litang578-coder/Antigravity-Code/README.md

# 基于STM32的锂电池太阳能智能充电系统设计

> 说明：本 README 根据毕业论文正文整理，已移除 Word 文档第一页封面、学号、姓名、学院、专业、指导教师等个人信息；为避免图片或截图携带敏感信息，本文仅保留文字、表格与参考文献，谢辞部分已省略。

## 摘要

随着新能源应用、嵌入式控制技术和物联网通信技术的发展，太阳能供电与锂电池储能相结合的充电系统在便携式电子设备、户外监测终端和低功耗物联网节点等场景中具有一定应用价值。太阳能板输出容易受到光照强度、环境温度和负载状态影响，输出电压、电流和功率具有波动性；同时，锂电池充电过程对电压、电流和温度控制要求较高，若缺少有效的状态监测和保护措施，容易影响电池寿命和系统运行安全。因此，设计一款具有太阳能输入调节、锂电池充电管理和远程监测功能的智能充电系统具有实际意义。

本文设计了一种基于STM32的锂电池太阳能智能充电系统。系统以STM32F103C8T6单片机作为主控核心，选取LM2596S DC-DC降压模块、TP4056锂电池充放电模块、INA226/INA3221电压电流采样模块、DS18B20温度检测模块、两路继电器模块、OLED显示模块和ESP8266无线通信模块完成样机搭建。硬件部分采用模块化方式实现太阳能输入、功率变换、锂电池充电、参数采集、执行保护、本地显示和无线通信等功能。软件部分围绕数据采集、充电状态判断、MPPT程序控制、继电器控制、MQTT通信、OneNET平台数据交互和移动端APP控制进行设计，实现了设备端采集、云平台传输和移动端显示控制之间的协同运行。

测试结果表明，系统能够完成太阳能充电管理、关键参数采集、本地状态显示、远程数据上传和异常保护等功能。在当前测试条件下，系统MPPT跟踪效率达到94%以上；充电阶段切换精度满足电压±0.02V、电流±50mA的设计要求；Wi-Fi通信延迟小于1s；硬件保护响应时间不超过10ms，软件保护响应时间不超过100ms；在典型阴天光照条件下，系统能够连续运行6h以上。该设计基本满足任务书提出的功能和性能指标，可为小型太阳能充电系统及低功耗物联网设备供电管理提供一定参考。

关键词：STM32；锂电池充电；MPPT；MQTT；太阳能供电

## Abstract

With the development of renewable energy, embedded control and IoT technology, solar charging systems for lithium batteries have been increasingly used in portable devices, outdoor monitoring terminals and low-power IoT nodes. However, the output of solar panels is affected by illumination, temperature and load, while lithium batteries require accurate control of voltage, current and temperature during charging. Therefore, this thesis designs an STM32-based intelligent solar charging system for lithium batteries.

The system uses STM32F103C8T6 as the main controller. Hardware modules such as the LM2596S DC-DC step-down module, TP4056 lithium battery charging module, INA226/INA3221 voltage and current sampling modules, DS18B20 temperature sensor, relay module, OLED display and ESP8266 Wi-Fi module are selected to build the system. The software realizes data acquisition, charging-state judgment, MPPT control, relay control, MQTT communication, OneNET data interaction and mobile APP control. The system can collect voltage, current, power, temperature and battery status, and upload the data to the cloud platform through MQTT.

Test results show that the system can complete solar charging management, parameter monitoring, local display, remote data uploading and safety protection. Under the current test conditions, the MPPT tracking efficiency is above 94%; the charging-stage switching accuracy meets the requirements of ±0.02V for voltage and ±50mA for current; the Wi-Fi communication delay is less than 1s; the protection response time meets the design requirements; and the system can operate continuously for more than 6h under typical cloudy conditions. The design basically meets the expected requirements and provides a reference for small solar charging systems and low-power IoT devices.

**Key words:** STM32; lithium battery charging; MPPT; MQTT; solar power supply

## 1 绪论

### 1.1 研究背景

随着新能源利用方式、嵌入式控制技术和物联网通信技术的发展，太阳能供电与锂电池储能相结合的充电系统逐渐应用于便携式电子设备、户外监测终端和低功耗物联网节点等场景。太阳能具有来源广泛、运行噪声低和环境友好等特点，但光伏板输出容易受到光照强度、环境温度和负载状态影响，其输出电压、电流和功率并不稳定。因此，在太阳能充电系统中，需要对输入功率变化进行检测和调节，以提高太阳能输入的利用效果[<sup>\[1\]</sup>](#_Ref3555)。

锂电池具有能量密度较高、自放电率较低和循环使用能力较好的特点，在智能终端、储能设备和嵌入式系统中应用广泛。与此同时，锂电池对充电电压、充电电流和工作温度较为敏感，若充电控制方式不合理，可能造成电池寿命下降，严重时还会影响系统运行安全。因此，锂电池充电过程通常需要结合涓流、恒流和恒压等阶段控制，并通过电压、电流和温度等参数监测为安全充电提供依据<sup>[\[2\]](#_Ref3832)[\[7\]](#_Ref3839)</sup>。

传统小型充电装置多侧重本地充电功能，对太阳能输入波动、电池状态变化和远程运行状态的综合管理不足。随着STM32微控制器、Wi-Fi通信模块和MQTT协议在物联网设备中的应用[<sup>\[3\]</sup>](#_Ref3907)，嵌入式系统可以同时完成数据采集、状态判断、执行控制和远程信息交互。基于此，本文围绕基于STM32的锂电池太阳能智能充电系统展开设计，将太阳能输入调节、锂电池充电管理和远程监测功能结合起来，具有一定的工程实践意义。

### 1.2 研究目的与意义

本文的研究目的是设计一套基于STM32的锂电池太阳能智能充电系统，使系统能够在太阳能输入不稳定的条件下完成锂电池充电管理、运行参数采集、安全保护和远程状态监测。系统以太阳能板作为输入源，以STM32作为主控单元，通过电压电流采样模块和温度检测模块获取系统运行状态，并结合继电器、显示模块和通信模块完成本地控制与远程交互。

本设计的意义主要体现在三个方面。首先，在能源利用方面，系统引入MPPT控制策略，使太阳能输入端能够根据采样结果调整工作点，为提高光伏输入利用率提供基础。其次，在电池管理方面，系统围绕锂电池充电特性进行阶段判断，并结合电压、电流、温度等信息实现保护控制，有助于提高充电过程的安全性。最后，在远程监测方面，系统通过ESP8266和MQTT协议上传运行信息，使用户能够在移动端查看电池状态、充电状态和异常提示，提升系统使用和调试的便利性。

### 1.3 本文主要研究内容

本文围绕“基于STM32的锂电池太阳能智能充电设计”展开研究，主要内容如下。

（1）分析锂电池太阳能充电系统的设计需求，明确系统需要完成的太阳能输入管理、锂电池充电控制、状态采集、安全保护、本地显示和远程通信等功能。

（2）研究光伏电池输出特性和常用MPPT控制方法，结合本系统的采样条件和控制需求，确定适用于样机设计的MPPT控制策略，为太阳能输入端工作点调整提供理论依据。

（3）完成系统总体方案与硬件模块选取，确定STM32主控模块、DC-DC降压模块、电压电流采样模块、温度检测模块、继电器模块、OLED显示模块和ESP8266通信模块之间的连接关系。

（4）完成系统软件设计，包括数据采集、锂电池充电阶段判断、MPPT程序控制、继电器控制、MQTT通信、移动端APP交互和异常保护逻辑。

（5）搭建系统样机并开展测试，对MPPT效率、充电阶段切换精度、通信延迟、安全保护响应和系统续航能力进行分析，验证系统功能和性能指标。

### 1.4 论文组织结构

本文共分为六章。第一章为绪论，介绍课题研究背景、研究目的与意义、主要研究内容和论文结构。第二章为MPPT控制策略，分析光伏电池输出特性、常用MPPT方法及本系统采用的控制思路。第三章为系统总体方案与硬件模块选取，说明系统功能架构和主要硬件模块的作用。第四章为软件设计与系统调试，介绍数据采集、充电控制、MPPT程序、MQTT通信和保护逻辑。第五章为系统测试与分析，对系统主要功能和性能指标进行测试。第六章为结论，总结全文工作并说明系统不足与改进方向。

### 1.5 本章小结

本章介绍了基于STM32的锂电池太阳能智能充电系统的研究背景和设计意义，明确了本文围绕太阳能输入、锂电池充电管理、参数采集、安全保护和远程通信开展研究，并对论文主要内容和章节安排进行了说明，为后续MPPT控制策略分析和系统方案设计奠定基础。

## 2 MPPT控制策略

### 2.1 光伏电池输出特性分析

#### 2.1.1 光伏电池工作原理

光伏电池是太阳能发电系统中的能量转换单元，其基本作用是利用半导体材料的光伏效应将太阳辐射能转换为直流电能。当光照照射到光伏电池表面时，半导体 PN 结内部产生电子—空穴对，并在内建电场作用下形成定向移动，从而在外部回路中产生电流。与普通直流电源不同，光伏电池的输出电压和输出电流并不是固定值，而是与光照强度、环境温度、负载状态以及组件自身参数有关。因此，在太阳能锂电池充电系统中，光伏板不能简单等效为稳定电压源，而应看作具有非线性输出特性的直流能源。

图2.1 光伏电池工作原理示意图

如图2.1所示，光伏电池在光照作用下产生电势差，并通过外部回路向负载输出电流。当负载状态发生变化时，光伏板输出电压和输出电流也会随之变化。对于本设计而言，太阳能板作为锂电池充电系统的前级输入源，其输出电能经 DC-DC 功率变换电路传递至锂电池端。由于户外光照条件具有不确定性，太阳能输入端电压、电流和功率会随着环境变化而波动。如果系统只采用固定占空比或简单稳压方式进行充电，光伏板可能长期偏离较优工作点，导致输入功率利用率下降。因此，系统引入最大功率点跟踪控制策略，根据采样得到的光伏输入电压和电流判断当前工作状态，并通过调节功率变换电路控制量，使光伏板工作点向最大功率点附近移动。

#### 2.1.2 光伏电池输出特性及最大功率点变化

光伏电池的输出特性通常通过电流—电压曲线和功率—电压曲线进行描述。电流—电压曲线反映了光伏电池在不同输出电压下对应的输出电流变化情况。当外部负载较小时，光伏电池输出电压较低，输出电流接近短路电流；随着负载等效阻值增大，输出电压逐渐升高，输出电流整体呈下降趋势；当输出端开路时，电流接近零，输出电压达到开路电压。由此可见，光伏电池的输出电流与输出电压之间并非线性关系，其工作点会随着负载变化在曲线上移动。

a.电压-电流特性曲线 b.电压-功率特性曲线

图2.2 不同光照强度下的光伏电池 I-U 与 P-U 特性曲线

如图2.2所示，光伏电池的输出功率由电压与电流乘积得到，即P=UI。在低电压区，虽然输出电流较大，但电压较低，因此输出功率较小；随着输出电压升高，功率逐渐增大；当工作点达到某一位置时，输出功率达到峰值，该点称为最大功率点。继续增大输出电压后，输出电流下降幅度增大，输出功率随之降低。因此，在一定光照和温度条件下，光伏电池的P-U曲线通常具有单峰特征，最大功率点位于曲线峰值附近。MPPT 控制的核心目标就是根据光伏板实时输出状态，使系统工作点尽量靠近峰值区域，从而提高太阳能输入端的能量利用率。

光伏电池最大功率点的位置并不是固定的，而是会随着光照强度、环境温度和负载状态变化而发生偏移。通常情况下，光照强度增大时，光伏电池能够产生更多光生载流子，输出电流明显增大，输出功率也随之提高；光照减弱时，输出电流下降，最大输出功率降低。相比之下，温度变化对光伏输出电压影响较为明显，当组件温度升高时，开路电压通常会下降，最大功率点电压也会发生变化。对于太阳能锂电池充电系统而言，光照条件还会受到天气、时间、遮挡和安装角度等因素影响。若系统缺少动态跟踪机制，则在光照快速变化或负载状态改变时，光伏板工作点可能偏离最大功率点，导致可利用输入功率降低。因此，本设计通过采集太阳能输入端电压、电流并计算功率变化，为后续DC-DC占空比调节和锂电池充电管理提供依据。

### 2.2 常用MPPT控制方法分析

#### 2.2.1 恒定电压法

恒定电压法是一种结构较为简单的最大功率点跟踪方法。该方法认为，在一定光照和温度条件下，光伏电池最大功率点电压与开路电压之间近似存在比例关系，因此可以通过设定一个接近最大功率点电压的参考值，使光伏板工作在相对较高的功率输出区域。该方法控制逻辑简单，计算量较小，对控制器运算能力和采样速度要求不高，适合硬件资源有限或控制精度要求不高的场合。

图2.3 恒定电压法控制流程图

如图2.3所示，恒定电压法的控制过程主要包括电压采样、参考电压比较和控制量调整。该方法的核心是利用固定参考电压近似代替最大功率点电压，在光照和温度变化较小时能够取得一定效果。但是，由于光伏电池最大功率点会随环境条件变化而移动，固定参考电压无法准确反映最大功率点的实时位置。当光照强度、组件温度或负载状态发生明显变化时，系统工作点可能偏离实际最大功率点，导致太阳能输入功率利用率下降。因此，恒定电压法更适合作为MPPT初始参考或简化控制方法。

#### 2.2.2 扰动观察法

扰动观察法是太阳能MPPT控制中应用较多的一种方法。该方法通过周期性改变光伏板工作电压或DC-DC变换器占空比，使系统工作点产生小幅扰动，并比较扰动前后输出功率的变化。如果扰动后输出功率增大，说明工作点向最大功率点方向移动，控制器继续沿原方向调整；如果扰动后输出功率减小，说明工作点远离最大功率点，控制器反向调整。其基本思想是通过“扰动—观察—判断—再扰动”的循环过程，使光伏板工作点逐渐靠近最大功率点。

图2.4 扰动观察法控制流程图

如图2.4所示，扰动观察法不需要建立复杂的光伏电池数学模型，只需采集电压、电流并计算功率变化即可完成控制判断，具有实现简单、程序结构清晰和工程应用方便等优点。对于STM32等嵌入式控制器而言，扰动观察法的计算量较小，便于通过定时采样和PWM占空比更新实现控制。但是，由于该方法需要不断施加扰动，系统在最大功率点附近通常会出现小幅振荡；当外界光照快速变化时，输出功率变化可能并不是由控制扰动引起，而是由环境变化引起，此时算法可能出现误判。因此，扰动观察法适合结构简单、光照变化较缓慢的场景。

#### 2.2.3 电导增量法

电导增量法是基于光伏电池P-U曲线斜率特性提出的MPPT控制方法<sup>[\[5\]](#_Ref4100)[\[10\]](#_Ref4110)</sup>。光伏输出功率可表示为P=UI，当光伏板工作在最大功率点时，功率对电压的导数为零；当工作点位于最大功率点左侧时，功率随电压增大而增大；当工作点位于最大功率点右侧时，功率随电压增大而减小。电导增量法正是利用这一特性，通过比较增量电导与瞬时电导之间的关系判断当前工作点位置，从而确定控制方向。

图2.5 电导增量法控制流程图

如图2.5所示，电导增量法的控制流程以电压、电流采样为基础，通过计算电压变化量和电流变化量判断工作点所处区域。在最大功率点左侧，功率随电压增加而增加，此时dP/dU\>0；在最大功率点处，功率达到峰值，满足dP/dU=0；在最大功率点右侧，功率随电压增加而下降，此时dP/dU\<0。根据P=UI可得，最大功率点处满足dI/dU=-I/U。实际程序中，连续导数无法直接获得，因此通常用相邻采样周期的电压变化量ΔU 和电流变化量ΔI近似表示dU和dI，再根据ΔI/ΔU与-I/U的关系判断工作点所在区域。

与恒定电压法和扰动观察法相比，电导增量法的判断依据更加明确，能够根据电压、电流变化趋势判断当前工作点与最大功率点之间的位置关系。当光照发生变化时，该方法可以利用电流和电压的同步变化进行判断，动态响应能力相对较好。其不足是算法计算量较扰动观察法略大，对电压、电流采样精度和滤波效果要求较高。如果采样数据波动较大，可能影响ΔU、ΔI的判断结果。因此，在实际应用中，电导增量法通常需要配合稳定的电压电流采样模块、适当的软件滤波和占空比限幅策略。结合本设计中 STM32 的控制能力以及INA226、INA3221等采样模块的应用条件，本文选取电导增量法作为 MPPT控制策略的主要依据。

### 2.3 本系统MPPT控制策略设计

#### 2.3.1 电导增量法控制原理

本设计采用以电导增量法为核心的MPPT控制策略。光伏电池输出功率由输出电压和输出电流共同决定，其表达式为：\
``` math
\begin{array}{r}
P = UI\#(2 - 1)
\end{array}
```

式中，P为光伏输出功率，U为光伏输出电压，I为光伏输出电流。对式（2-1）两边关于电压 U 求导，可得：

``` math
\begin{array}{r}
\frac{dP}{dU} = \frac{d(UI)}{dU} = I + U\frac{dI}{dU}\#(2 - 2)
\end{array}
```

在光伏电池P-U特性曲线上，最大功率点处输出功率达到峰值，此时功率对电压的导数为零，即：

``` math
\begin{array}{r}
\frac{dP}{dU} = 0\#(2 - 3)
\end{array}
```

将式（2-3）代入式（2-2）可得最大功率点处的判断条件：

``` math
\begin{array}{r}
\frac{dI}{dU} = - \frac{I}{U}\#(2 - 4)
\end{array}
```

由式（2-4）可知，电导增量法的核心是比较增量电导dI/dU与瞬时电导-I/U的关系。当dI/dU大于-I/U时，说明工作点位于最大功率点左侧，此时增大光伏工作电压会使输出功率增加；当dI/dU小于-I/U时，说明工作点位于最大功率点右侧，此时继续增大光伏工作电压会使输出功率下降；当dI/dU等于-I/U时，说明工作点接近最大功率点。通过这一判断关系，控制器可以确定工作点调整方向，并通过PWM占空比改变DC-DC变换电路的工作状态。

#### 2.3.2 离散化判断与控制流程

在实际嵌入式系统中，STM32无法直接获得连续形式的dI和dU，因此程序需要根据相邻两个采样周期的电压、电流数据进行离散化处理。设当前采样周期为k，上一采样周期为k-1，则光伏输入电压变化量和电流变化量可分别表示为：

``` math
\begin{array}{r}
\Delta U = U(k) - U(k - 1)\#(2 - 5)
\end{array}
```

``` math
\begin{array}{r}
\Delta I = I(k) - I(k - 1)\#(2 - 6)
\end{array}
```

式中，U(k)和 I(k)分别为当前周期采集到的光伏输入电压和电流，U(k-1)和I(k-1)分别为上一周期采样值。利用ΔI/ΔU近似代替dI/dU，程序即可根据离散采样数据判断工作点与最大功率点之间的关系。当ΔU不为零时，程序通过比较ΔI/ΔU与-I/U的大小关系确定占空比调整方向；当ΔU=0时，程序根据ΔI的变化进行判断。若ΔI=0，则说明当前工作点基本稳定；若ΔI\>0，则说明输出电流增大，系统可根据控制方向进行适当调整；若ΔI\<0，则说明输出电流减小，系统需反向调整或维持安全范围内的控制量。

图2.6 本系统电导增量法MPPT控制流程图

如图2.6所示，本系统MPPT控制流程以采样数据为基础。STM32首先完成系统初始化，随后周期性读取太阳能输入端电压和电流，并计算当前输入功率。程序将当前周期采样数据与上一周期采样数据进行比较，得到ΔU和ΔI，再根据电导增量法判断工作点位置。若判断结果表明当前工作点偏离最大功率点，STM32通过改变PWM占空比或参考输出量调整DC-DC变换电路，使太阳能板等效负载发生变化，从而使工作点向功率增大的方向移动。调整完成后，程序对占空比进行限幅处理，并将当前采样值保存为下一周期的历史数据。

综上，本设计采用以电导增量法为核心的MPPT控制策略，通过采样光伏输入电压和电流，计算功率变化及增量电导关系，判断当前工作点相对最大功率点的位置，并利用STM32输出PWM控制量调节DC-DC变换电路。与此同时，系统将MPPT控制与锂电池涓流、恒流、恒压充电阶段相结合[<sup>\[9\]</sup>](#_Ref4276)，并通过电压、电流、温度和继电器状态判断实现安全约束。该控制策略既能提高太阳能输入端的能量利用率，又能满足锂电池充电过程对安全性和稳定性的要求，为后续硬件系统设计和软件程序实现提供理论依据。

### 2.4 本章小结

本章围绕基于STM32的锂电池太阳能智能充电系统中的MPPT控制策略展开分析。首先，对光伏电池的工作原理、I-U特性曲线和P-U特性曲线进行了说明，明确了光伏板输出电压、电流和功率会受到光照强度、环境温度和负载状态等因素影响，并指出最大功率点会随外部条件变化而发生偏移。其次，对恒定电压法、扰动观察法和电导增量法进行了对比分析[<sup>\[4\]</sup>](#_Ref4378)，结合本设计中STM32的控制能力和电压电流采样条件，选取电导增量法作为MPPT控制策略的主要依据。最后，本章推导了电导增量法的最大功率点判断关系，说明了离散采样条件下ΔU、ΔI和PWM占空比在控制过程中的作用，并分析了MPPT控制与锂电池充电阶段之间的协调关系。上述内容为后续系统总体方案设计、硬件电路设计和软件程序实现提供理论基础。

## 3 系统总体方案与硬件模块选取

### 3.1 系统设计需求分析

基于STM32的锂电池太阳能智能充电系统面向户外低功耗设备、便携式电子设备和分布式传感节点等供电场景<sup>[\[8\]](#_Ref4456)[\[11\]](#_Ref4459)</sup>，主要目标是在太阳能输入功率不稳定的条件下，实现锂电池安全充电、关键参数监测、本地状态显示和远程数据交互。系统以太阳能板作为输入能源，通过DC-DC降压模块将太阳能输入转换为适合锂电池充电的电压范围，并结合第二章所述MPPT控制策略对太阳能输入端工作点进行调节。

在充电管理方面，系统围绕锂电池涓流、恒流、恒压及满充判断过程展开。STM32主控模块根据电池端电压、电流、温度和SOC等参数判断当前充电状态，并通过继电器模块控制充电通断和电池通道切换。在参数采集方面，系统需要获取太阳能输入端、电池端和负载端的电压、电流、功率以及温度信息，为MPPT控制、充电状态判断、异常保护和远程显示提供数据基础。

在通信与人机交互方面，系统通过OLED显示模块实现本地参数显示，通过ESP8266 Wi-Fi模块接入OneNET平台，并基于MQTT协议上传电压、电流、温度、SOC、继电器状态和告警信息。移动端APP可读取云平台数据并下发充电开关控制命令，使系统具备一定的远程监测和控制能力。

### 3.2 系统总体架构与主控模块选取

本系统采用模块化搭建方式，以STM32F103C8T6主控模块为核心，将太阳能输入模块、LM2596S DC-DC降压模块、TP4056锂电池充放电模块、INA226/INA3221电压电流采样模块、DS18B20温度检测模块、两路继电器模块、OLED显示模块、蜂鸣器、按键模块和ESP8266通信模块进行集成。各模块围绕STM32主控模块展开连接，形成“能源输入—参数采集—主控判断—执行保护—显示通信”的系统结构。

本系统选取STM32F103C8T6作为主控模块。该型号单片机具有资料丰富、成本较低、外设资源较完整和开发环境成熟等特点，适合本科毕业设计样机开发。STM32F103C8T6具备I2C、USART、GPIO、ADC、定时器和PWM等资源，能够满足本系统对采样读取、继电器控制、显示刷新、通信交互和PWM调节的需求。STM32外设引脚分布如图3.1所示。

图 3.1 STM32外设引脚图

STM32将采集到的运行数据通过USART发送至ESP8266，ESP8266接入Wi-Fi网络后，基于MQTT协议将数据上传至OneNET平台。移动端APP读取云平台设备属性，实现电压、电流、温度、SOC、充电开关和继电器状态显示，并可向设备端下发充电开关控制命令。系统总体框图如图3.2所示。

图3.2 系统总体框图

由图3.2可知，本系统通过模块化方式将能源输入、功率变换、参数采集、充电管理、执行保护、本地显示和无线通信等功能连接在一起。STM32作为系统主控核心，既负责各类采样数据的读取与处理，也负责继电器、OLED、ESP8266等外设模块的协调控制。该结构层次清晰，便于后续软件程序设计、功能调试和系统测试。

STM32F103C8T6具备I2C、USART、GPIO、ADC、定时器和PWM等资源，能够满足本系统对采样读取、继电器控制、显示刷新、通信交互和PWM调节的需求。

在系统运行过程中，STM32主控模块承担数据处理中心和控制中心的作用。一方面，它周期读取INA226、INA3221和DS18B20等模块的采样数据；另一方面，它根据采样结果完成充电状态判断、MPPT控制量计算、异常保护判断和通信数据封装。

### 3.3 能源输入与充放电模块选取

#### 3.3.1 LM2596S DC-DC降压模块

本系统选取以LM2596S电源芯片为核心的DC-DC降压模块作为太阳能输入端与锂电池端之间的功率变换单元[<sup>\[6\]</sup>](#_Ref4567)。LM2596S属于开关型降压电源芯片，其模块内部集成开关管控制、储能电感、续流二极管和滤波电容等部分，可将较高或波动的直流输入转换为较低的稳定直流输出，其原理图如图3.3所示。

图3.3 DC-DC功率变换模块原理图

LM2596S降压模块的基本工作过程可结合Buck降压原理进行说明。开关导通时，输入端能量经电感传递至输出端，同时电感储能；开关关断时，电感通过续流路径向负载释放能量。通过改变开关导通时间在一个周期中所占比例，模块可以调节输出电压。在理想连续电流模式下，Buck降压模块的输出电压等于占空比与输入电压的乘积，即Uo=DUi，其中Uo为输出电压，Ui为输入电压，D为开关占空比。因此，占空比可表示为D=Uo/Ui。该关系说明，当输入电压一定时，占空比增大，输出电压随之升高；占空比减小，输出电压随之降低。

从能量转换角度分析，模块输入功率等于输入电压与输入电流的乘积，即Pin=UiIi；输出功率等于输出电压与输出电流的乘积，即Pout=UoIo。由于实际模块中存在开关损耗、电感铜损、二极管压降损耗和芯片发热损耗，输出功率通常小于输入功率。转换效率等于Pout/Pin×100%=UoIo/(UiIi)×100%。系统通过INA226或INA3221对输入端和输出端电压、电流进行采样，可进一步计算输入功率、输出功率和转换效率，为后续MPPT效率测试和系统能量分析提供数据基础。

#### 3.3.2 TP4056锂电池充放电模块

本系统选取TP4056模块作为单节锂电池充放电管理模块。TP4056是常用的线性锂电池充电管理芯片，适合对单节3.7V锂电池进行恒流、恒压充电控制。该模块外围结构简单，成本较低，适合小功率锂电池充电样机使用，其原理图如图3.4示。

图3.4 TP4056充放电模块原理图

TP4056模块的充电过程主要包括涓流充电、恒流充电和恒压充电三个阶段。当电池电压较低时，模块以较小电流对电池进行预充电；当电池电压上升到一定范围后，模块进入恒流充电阶段，充电电流保持在设定值附近；当电池电压接近满充状态时，模块进入恒压充电阶段，电池端电压基本保持在4.2V左右，充电电流逐渐减小，直至达到截止条件。

从电池端能量输入角度看，锂电池充电功率等于电池端电压与充电电流的乘积，即Pch=UBATIBAT，其中UBAT为电池端电压，IBAT为电池充电电流。TP4056的恒流充电电流由PROG引脚外接电阻设定，其近似关系为ICHG≈1200/RPROG，其中RPROG的单位为Ω，ICHG的单位为A。例如，当RPROG取1.2kΩ时，恒流充电电流约为1A。实际充电电流还会受到输入电源能力、芯片温升和电池状态影响。

在恒压阶段，TP4056将电池端电压控制在约4.2V，即UBAT≈4.2V。随着充电过程继续进行，电池充电电流逐渐减小，当IBAT≤0.1ICHG时，可近似认为电池接近满充状态。本系统利用TP4056模块完成锂电池基本充电管理，同时通过STM32对电池端电压、电流和温度进行采集，并结合继电器模块实现充电通断控制和异常保护。TP4056负责单节锂电池的基本充电过程，STM32则负责系统级状态监测、保护判断和远程通信管理，两者共同构成锂电池充电管理部分。

#### 3.3.3 能源模块与MPPT控制策略的关系

第二章已经对MPPT控制策略进行了分析，本节主要说明能源模块与MPPT控制之间的硬件关系。MPPT控制依赖太阳能输入端电压、电流和功率采样，同时通过LM2596S降压模块改变太阳能板等效负载。STM32读取太阳能输入端采样数据后，计算输入功率，并根据MPPT控制策略调整PWM或参考控制量，使降压模块工作状态发生变化。该过程使太阳能板工作点能够随外界光照变化进行调整，从而提高太阳能输入端功率利用率。

### 3.4 参数采集与温度检测模块选取

#### 3.4.1 INA226与INA3221电压电流采样模块

系统选取INA226和INA3221作为电压电流采样模块。INA226适合用于单通道重点支路采样，可获取该支路电压、电流和功率信息；INA3221具备多通道采样能力，适合同时监测太阳能输入端、电池端和负载端等多个位置的运行状态。两类模块均通过I2C总线与STM32通信，能够减少主控引脚占用并简化模块连接关系。

图3.5 INA226模块原理图

图3.6 INA3221模块原理图

INA226和INA3221的电流检测可结合采样电阻原理进行说明。当被测支路电流流过采样电阻时，采样电阻两端会产生压降。根据欧姆定律，采样电阻两端电压等于被测电流与采样电阻阻值的乘积，即Ushunt=IRshunt。因此，被测电流等于采样电阻两端电压除以采样电阻阻值，即I=Ushunt/Rshunt。模块内部将采样电阻压差和总线电压转换为数字量，并通过I2C总线发送至STM32。

STM32获取电压和电流后，可进一步计算支路功率。功率等于电压与电流的乘积，即P=UI。该功率数据既用于OLED和APP状态显示，也用于MPPT控制策略中判断太阳能输入端工作点变化方向。电池端采样数据用于充电阶段判断和满充检测，负载端或输出端采样数据用于系统运行状态显示和异常保护判断。因此，INA226和INA3221是系统参数监测与控制判断的重要数据来源。

#### 3.4.2 DS18B20温度检测模块

温度检测模块选取DS18B20，用于采集电池附近或系统内部温度。DS18B20具有数字化输出、接线简单和抗干扰能力较好的特点，适合嵌入式系统温度检测。系统运行过程中，STM32周期读取温度值，并将温度数据用于过温保护和状态显示。

系统过温保护判断条件可表示为当前温度大于或等于设定温度阈值，即T≥Tmax，其中T为当前采集温度，Tmax为系统设定的温度保护阈值。当采集温度超过设定阈值时，STM32控制继电器断开充电路径，并通过OLED、蜂鸣器和云端状态上报提示异常。温度数据与电压、电流数据共同参与系统保护判断，使系统在锂电池充电过程中具备更完整的安全监测能力。

### 3.5 执行保护与人机交互模块选取

#### 3.5.1 两路继电器模块

本系统选取两路继电器模块作为执行控制模块。继电器属于电磁式开关器件，其控制侧由线圈和驱动部分组成，触点侧接入被控制的功率通道。当STM32的GPIO输出控制信号后，继电器模块内部驱动单元使线圈得电，线圈产生磁场吸合触点，从而改变功率回路通断状态，其原理图如图3.7所示。

图3.7 两路继电器模块原理图

继电器线圈电流可由欧姆定律近似表示，线圈电流等于线圈工作电压除以线圈等效电阻，即Icoil=Ucoil/Rcoil，其中Ucoil为继电器线圈工作电压，Rcoil为线圈等效电阻。由于STM32 GPIO输出电流有限，不能直接驱动继电器线圈，因此两路继电器模块通常集成三极管或光耦驱动单元以及续流二极管。三极管工作在开关状态时，可将STM32的小电流控制信号转换为继电器线圈所需的驱动电流；续流二极管用于在线圈断电瞬间释放电感储能，减小反向感应电压对主控引脚和驱动器件的冲击。

继电器触点侧承担功率通断任务，其负载功率等于负载电压与负载电流的乘积，即Pload=UloadIload。为了保证继电器触点在系统运行中具有足够余量，继电器触点允许电流应大于实际负载电流，可表示为Icontact≥kIload，其中Icontact为继电器触点允许电流，Iload为实际负载电流，k为安全裕量系数。本系统采用两路继电器模块，其中一路用于太阳能充电通断控制，另一路用于BAT1/BAT2电池通道切换。当系统检测到过压、过流、过温等异常状态时，STM32控制继电器断开相应通道，从而实现硬件执行层面的保护动作。

#### 3.5.2 OLED显示、按键与蜂鸣器模块

人机交互模块主要由OLED显示模块、按键模块和蜂鸣器模块组成。OLED通过I2C接口与STM32通信，用于显示电池电压、电流、温度、SOC、继电器状态、当前电池通道和通信状态等信息。按键模块用于本地页面切换或手动控制，便于系统在无网络环境下完成基本操作。蜂鸣器模块用于异常状态提示，当系统发生过压、过流、过温或充电异常时，蜂鸣器能够提供本地报警信息。

### 3.6 无线通信模块与接口板连接关系

#### 3.6.1 ESP8266无线通信模块

无线通信部分选取ESP8266 Wi-Fi模块。该模块成本较低、资料丰富，能够通过串口与STM32通信，并接入Wi-Fi网络完成云平台数据交互。系统运行时，STM32将采集到的电压、电流、温度、SOC、继电器状态和告警信息封装后发送至ESP8266，由ESP8266通过MQTT协议上传至OneNET平台。MQTT采用发布/订阅机制，适合物联网设备端与平台之间进行轻量级数据传输和远程控制。

移动端APP通过OneNET平台读取设备属性，实现太阳能输入状态、电池状态和告警信息显示。当用户在APP中操作充电开关时，控制命令经云平台下发至设备端，再由ESP8266转发给STM32，最终控制两路继电器模块动作。通过该通信链路，系统能够实现本地充电管理与远程状态监测之间的数据同步。

#### 3.6.2 接口板与模块连接关系

由于本系统采用模块化搭建方式，接口板主要承担模块连接、信号转接和电源分配作用。接口板集中引出VCC、GND、I2C、USART、GPIO、PWM和功率端子等连接点，使STM32主控模块能够与各功能模块建立稳定连接。其中，I2C总线连接INA226、INA3221和OLED；USART接口连接ESP8266；GPIO接口连接两路继电器、按键和蜂鸣器；PWM或调节端连接LM2596S降压模块；功率端子连接太阳能输入、TP4056模块、锂电池和负载端。

系统硬件实物连接关系如图3.8所示。由图3.8可以看出，STM32主控模块位于系统控制中心位置，周围分别连接采样模块、显示模块、通信模块和执行模块。太阳能输入端经LM2596S降压模块接入TP4056充放电模块，再连接锂电池储能端，构成系统主要功率传输路径。INA226和INA3221采样模块接入太阳能输入端、电池端或负载端，用于获取电压、电流和功率数据；DS18B20温度检测模块布置在靠近电池或系统发热位置，用于采集温度信息；OLED、按键和蜂鸣器构成本地人机交互部分；ESP8266模块通过串口与STM32连接，用于Wi-Fi入网和MQTT数据上传。

图3.8 硬件实物连接图

从实物连接方式看，功率通道和弱信号通道在功能上相对独立。功率通道主要包括太阳能输入、LM2596S降压、TP4056充电、锂电池储能和继电器通断部分，承担系统能量传输任务；弱信号通道主要包括I2C采样总线、USART通信线、GPIO控制线和OLED显示线，承担数据采集、状态显示和控制信号传输任务。通过接口板将不同模块集中连接，可以减少飞线混乱，提高系统整体结构的清晰度，也便于后续进行单模块检查、程序调试和整机测试。

两路继电器模块在实物连接中承担执行控制作用，其中一路用于太阳能充电通断控制，另一路用于BAT1/BAT2电池通道切换。当STM32检测到过压、过流、过温等异常状态时，可通过GPIO控制继电器断开相应功率通道；当移动端APP下发充电开关命令后，ESP8266将命令转发给STM32，再由STM32控制继电器模块完成充电通断动作。因此，图3.8不仅体现了各硬件模块之间的连接关系，也反映了系统“采样—判断—执行—显示—上传”的整体工作过程。

### 3.7 本章小结

本章围绕基于STM32的锂电池太阳能智能充电系统，完成了系统设计需求分析、总体架构设计和主要硬件模块选取。系统以STM32F103C8T6主控模块为核心，通过LM2596S DC-DC降压模块、TP4056锂电池充放电模块、INA226/INA3221电压电流采样模块、DS18B20温度检测模块、两路继电器模块、OLED显示模块和ESP8266通信模块，实现太阳能输入变换、锂电池充电管理、参数采集、执行保护、本地显示和远程通信等功能。本章内容为后续软件程序设计、系统调试和测试分析提供了硬件模块基础。

## 4 软件设计与系统调试

### 4.1 软件总体设计

本系统软件以STM32主控程序为核心，采用模块化方式完成数据采集、充电控制、本地显示、无线通信、移动端交互和异常保护等功能。软件结构与第三章所述硬件模块相对应，主要包括主程序调度模块、传感数据采集模块、锂电池充电控制模块、MPPT控制模块、OLED显示模块、无线通信模块、移动端APP模块和保护处理模块，系统软件总体流程如图4.1所示

图4.1 软件总体设计流程图

系统上电后，程序首先完成主控时钟、延时函数、继电器、温度检测、OLED显示、串口通信、定时器、电压电流采样、按键、蜂鸣器、无线通信模块和云平台连接等初始化工作。初始化完成后，程序进入循环运行状态。在主循环中，系统周期性完成按键检测、温度采集、电压电流采样、电池通道判断、充电状态判断、OLED显示刷新、云平台数据上报以及移动端控制命令解析。各功能模块之间通过主程序调度实现协同运行，使系统形成“数据采集—状态判断—控制执行—本地显示—远程交互”的软件工作流程。

### 4.2 数据采集与本地显示程序设计

数据采集程序是系统实现充电控制和远程监测的基础。系统通过多通道电压电流采样模块获取太阳能输入端、电池端和负载端的电压、电流等数据，并通过单通道采样模块对关键支路进行辅助检测。温度检测模块用于采集电池附近或系统运行环境温度，为过温保护和状态显示提供依据。采样数据经过程序更新后，被送入充电控制、保护判断、本地显示和云端上报等流程，数据采集程序流程如图4.2所示。

图4.2 数据采集程序流程图

在采样周期内，程序先读取温度数据，再更新多通道电压电流数据，随后读取重点支路电压、电流值。对于温度采集，当传感器通信异常或读取失败时，程序会重新启动温度转换过程，以保证后续采样能够继续进行。对于电压电流采样，程序根据当前电池通道选择对应的数据作为电池端状态量，并将采样结果用于充电阶段判断和电池状态估算。

OLED显示程序采用菜单式显示方式。当系统处于主界面时，屏幕显示继电器状态、当前电池通道、温度、电压和电流等基本信息；当切换到详情界面时，屏幕显示多通道采样模块的各路电压、电流和电池电量状态。该显示方式能够在不依赖移动端的情况下完成本地状态查看，便于样机调试和运行观察。

### 4.3 锂电池充电控制与电池通道切换程序设计

锂电池充电控制程序主要完成充电开关控制、满充判断和两路电池通道切换。系统设置两路电池通道，程序根据当前继电器状态确定正在充电的电池。当用户通过按键进行手动切换时，程序切换到另一电池通道，同时更新采样模块中的当前检测对象。为降低通道切换瞬间采样波动带来的影响，程序设置了切换稳定等待过程，使系统在通道切换后经过短暂稳定时间再进行满充判断，锂电池充电控制流程如图4.3所示。

图4.3 锂电池充电控制程序流程图

由图4.3可知，在充电过程中，电压和电流双条件判断电池是否接近满充。当电池端电压达到设定阈值且充电电流下降到较低水平时，程序不会立即认定电池满充，而是通过连续确认的方式进行判断。只有连续多个采样周期均满足满充条件，系统才将当前电池标记为满充状态。若另一通道电池尚未满充，系统自动切换至另一电池继续充电；若两路电池均达到满充条件，则关闭充电继电器，停止继续充电。

该部分实现的是两路电池通道切换与满充管理，不属于完整的多节电池均衡管理。通过继电器通道切换、采样数据判断和连续确认机制，系统能够在样机条件下完成两路电池的轮流充电控制，并避免由于瞬时波动导致的误切换。

### 4.4 MPPT程序设计

MPPT控制策略的理论推导已在第二章完成，因此本节不再列出公式，只从程序实现角度说明其运行流程。系统软件中设置了独立的MPPT程序模块，用于保存光伏输入电压、电流、历史采样值、扰动步长、参考输出量和占空比等控制参数。该模块完成初始化后，可根据光伏侧采样数据判断工作点变化方向，并为PWM调节提供参考量，MPPT程序控制流程如图4.4所示。

图4.4 MPPT算法程序流程图

由图4.4可知，程序首先读取光伏输入端的电压和电流，并与上一周期采样值进行比较。随后，程序根据电压、电流变化关系判断当前工作点相对于最大功率点的位置。当判断结果显示工作点偏离最大功率点时，程序按照设定步长调整参考输出量；当工作点接近最大功率点时，程序保持或小幅修正参考量，以降低工作点附近的振荡。参考量更新后，程序会进行上下限约束，防止占空比过高或过低影响系统稳定性。

在本系统软件中，MPPT程序采用模块化方式进行设计，主要完成光伏输入采样、工作点方向判断、参考量更新和PWM调节接口设计。该模块与数据采集程序和PWM输出程序相配合，为太阳能输入端工作点调节提供软件基础。同时，MPPT调节过程还需与锂电池充电状态判断、继电器控制和异常保护逻辑协调运行，以保证太阳能输入利用率和锂电池充电安全之间的平衡。

### 4.5 MQTT通信与OneNET数据交互程序设计

无线通信程序由STM32主控、ESP8266通信模块、MQTT协议处理程序和OneNET平台交互程序共同完成。系统启动后，主控通过串口与ESP8266模块通信，完成无线模块初始化、网络连接和云平台服务器连接。平台连接成功后，系统进入数据交互状态，并订阅平台下发控制命令的相关主题，使设备端具备接收远程控制量的能力，MQTT通信程序流程如图4.5所示。

图4.5 MQTT通信程序流程图

在数据上传过程中，主程序周期性组织系统运行数据，包括温度、电压、电流、电池电量状态、继电器状态、当前电池通道和报警状态等内容，并通过MQTT协议上传至OneNET平台。平台接收到数据后，移动端APP可以通过物模型接口读取设备属性，实现远程监测。对于平台或移动端下发的控制命令，设备端接收后进行解析，并根据命令内容更新充电开关或继电器状态。

该通信方式利用MQTT发布/订阅机制实现设备端与平台端的数据交互。设备端负责采集和上传运行数据，云平台负责数据转发和属性管理，移动端APP负责状态显示和控制操作。通过这种结构，系统实现了本地控制与远程监测的结合。

### 4.6 移动端APP程序设计

移动端APP采用uni-app和Vue框架实现，主要用于显示系统运行状态和下发充电控制命令。APP首页由状态显示区、关键参数卡片、电池电量显示区、充电控制区和电压趋势显示区组成，能够集中展示温度、电压、电流、电池电量、当前电池通道、充电状态和设备在线状态等信息。

APP页面进入后，程序首先完成访问凭证生成和页面状态初始化，随后周期性向OneNET平台请求设备属性数据。获取到数据后，APP将温度、电压、电流、电池电量和电池通道等信息更新到页面中，并根据连续采样结果绘制电压趋势曲线。为了改善显示效果，页面对部分数据采用平滑更新方式，使数值变化更加自然。

在远程控制方面，APP设置了太阳能充电开关控制区域。当用户点击开关后，APP向OneNET平台发送属性设置请求，平台再将控制命令下发到设备端。若控制命令下发失败或平台返回异常，APP会恢复原有开关状态并给出失败提示，避免页面状态与设备实际状态不一致。通过该流程，移动端实现了设备状态查看、充电控制和异常提示等功能，移动端APP程序流程如图4.6所示。

图4.6 移动端APP程序流程图

由图4.6可知，APP主要通过周期性属性查询完成状态刷新，并通过属性设置接口完成充电开关控制。该流程使移动端页面能够及时反映设备端状态，并为用户提供远程控制入口。

图4.7 人机交互过程图

为进一步说明设备端、OneNET云平台和移动端APP之间的数据传递关系，系统人机交互过程如图4.7所示。由图可知，设备端负责采集温度、电压、电流、电池电量和继电器状态等信息，并将数据上传至OneNET云平台；移动端APP通过平台读取设备状态并刷新页面显示，同时可将充电开关控制命令经平台下发至设备端。图中蓝色箭头表示数据上传方向，绿色箭头表示控制命令下发方向，虚线箭头表示移动端的周期刷新过程。该交互结构实现了设备端采集、云平台中转和移动端显示控制之间的协同。

### 4.7 保护与调试程序设计

系统保护程序主要围绕温度异常、充电继电器控制和本地报警展开。程序中设置了温度保护阈值，当温度采集结果高于设定值时，系统置位报警状态并关闭充电继电器，防止电池在异常温度条件下继续充电。同时，蜂鸣器进入报警提示状态，OLED显示当前温度、电压、电流和继电器状态，便于用户及时发现异常。

系统调试过程按照由单模块到整机联调的顺序进行。首先验证OLED、按键、蜂鸣器和继电器等基础模块是否能够正常响应；随后验证温度检测和电压电流采样数据是否能够正常显示；在本地显示正常后，继续验证ESP8266与OneNET平台之间的数据连接和属性上传；最后通过移动端APP检查远程状态显示和充电开关控制功能。MPPT模块作为独立程序单元参与软件控制流程，其调试重点包括光伏侧采样数据更新、PWM调节参考量变化以及与充电控制逻辑之间的协调关系。

系统软件调试流程如图4.8所示。由图可知，系统调试按照基础外设、采样显示、继电器动作、云平台通信、移动端控制和MPPT接口验证的顺序逐步展开，能够减少多模块同时调试带来的定位难度。通过分阶段调试方式，可以逐步确认各软件模块的运行状态，并提高整机联调效率。

### 4.8 本章小结

本章围绕基于STM32的锂电池太阳能智能充电系统，对软件总体流程、数据采集与本地显示、锂电池充电控制、电池通道切换、MPPT程序、MQTT通信、移动端APP和保护调试流程进行了说明。系统软件以主程序调度为核心，通过各功能模块协同完成参数采集、状态判断、继电器执行、OLED显示、云平台数据上传和移动端远程控制，为后续系统测试与结果分析提供程序基础。

## 5 系统测试与分析

### 5.1 测试目的与测试平台

系统测试是评价基于STM32的锂电池太阳能智能充电系统运行效果的重要环节。本章围绕太阳能输入、MPPT最大功率点跟踪、锂电池充电控制、参数监测、MQTT通信、安全保护和系统续航等内容开展测试，重点验证系统在当前实验条件下是否达到任务书提出的性能指标。

测试平台由STM32主控板、太阳能电板或可调直流电源、锂电池、DC-DC降压模块、INA226/INA3221电压电流检测模块、DS18B20温度检测模块、OLED显示模块、ESP8266Wi-Fi模块、OneNET云平台、移动端APP、万用表和示波器等组成。测试过程中，通过INA226/INA3221采集太阳能输入侧和电池侧电压、电流及功率参数，通过万用表对关键电压、电流数据进行辅助校验，并结合串口日志、OneNET平台设备日志和移动端显示结果判断系统运行状态。

本系统测试所用锂电池标称电压为3.7V，额定容量为1200mAh，额定能量为4.44Wh。太阳能电板额定工作电压为9V，开路电压为11.5V，峰值电流为220mA，短路电流为240mA，额定功率为2W。由额定工作电压和峰值电流可知，太阳能板最大功率点附近输出功率约为9V×0.22A=1.98W，与2W额定功率基本一致。因此，后续MPPT测试和续航测试均围绕该功率范围展开，避免测试数据超出器件额定输出能力。

根据任务书要求，本章测试指标主要包括：MPPT效率不低于94%；充电阶段切换精度中，电压误差不超过±0.02V，电流误差不超过±50mA；Wi-Fi通信延迟不超过1s；硬件保护响应时间不超过10ms，软件保护响应时间不超过100ms；典型阴天光照条件下系统连续续航时间不低于6h。以下各节按照上述指标分别进行测试和分析。

### 5.2 MPPT 效率测试

根据额定功率与工作电压、电流之间的关系，最大功率点功率约为9V×0.22A=1.98W，与标称功率基本一致。因此，在光伏特性仿真中，将工作电压9V作为最大功率点电压，将峰值电流220mA作为最大功率点电流，通过MATLAB仿真验证其特性曲线图5.1所示。

a.U-I特性曲线 b. U-P特性曲线

图5.1 光伏特性曲线

测试时采用可调直流电源模拟标准测试条件下太阳能电板工作点位于最大功率点左侧和右侧的情况。系统运行稳定后，记录太阳能输入端电压Vin和输入电流Iin，并按Pin=Vin×Iin计算实际输入功率。由于本系统所用太阳能电板额定功率为2W，因此将Pmax=2W作为理论最大功率，MPPT跟踪效率按ηMPPT=Pin/Pmax×100%计算。通过该方法分别得到不同工作点下的MPPT效率，用于判断系统对太阳能输入最大功率点的跟踪效果。

a.直流电源输入值 b.实际输入测量值

图5.2 工作点在最大功率点左边

a.直流电源输入值 b.实际输入测量值

图5.3 工作点在最大功率点右边

由图5.2和图5.3可知，当工作点分别位于最大功率点左侧和右侧时，系统均能够根据太阳能输入端电压、电流变化调整控制方向，使工作点向最大功率点附近移动。结合太阳能电板2W额定功率计算，图5-2所示工况下MPPT效率约为96.6%，图5-3所示工况下MPPT效率约为95.3%，均高于任务书规定的94%指标。结合图5-1所示光伏特性曲线可知，本系统在当前实验条件下能够完成太阳能输入端最大功率点跟踪功能，测试结果满足MPPT效率要求。

### 5.3 充电阶段切换精度测试

充电阶段切换精度测试用于验证本系统在涓流、恒流和恒压充电阶段之间的切换准确性。测试过程中调整锂电池初始电压，或在连续充电过程中观察阶段切换点，并将系统采样值与万用表实测值进行对比。电压类项目以阶段切换时的电池端电压作为评价对象，电流类项目以恒流控制电流和截止电流判断值作为评价对象。

表5.1 充电阶段切换精度测试结果

| 测试项目 | 设定阈值 | 实测切换值 |  误差  | 指标要求 | 是否达标 |
|:---:|:---:|:---:|:---:|:---:|:---:|
| 涓流转恒流电压 |  3.00V | 3.01V | +0.01V |  ±0.02V  | 达标 |
| 恒流转恒压电压 |  4.20V | 4.19V | -0.01V |  ±0.02V  | 达标 |
|  恒流充电电流  |  0.22A | 0.235A | +15mA  |  ±50mA | 达标 |
|  截止电流判断  |  0.10A | 0.107 |  -7mA  |  ±50mA | 达标 |

由表5.1可知，涓流转恒流电压误差为+0.01V，恒流转恒压电压误差为-0.01V，均处于任务书规定的±0.02V范围内；恒流充电电流误差为+15mA，截止电流判断误差为-7mA，均小于±50mA的指标要求。由于本系统所用太阳能电板峰值电流为220mA，恒流阶段电流设置在0.20A附近更符合实际输入能力。测试结果表明，系统在当前测试条件下能够完成三阶段充电切换和电流控制。

### 5.4 MQTT 通信与移动端功能测试

MQTT通信与移动端功能测试用于验证设备端数据上报、OneNET平台属性同步和移动端显示控制链路是否能够贯通。测试过程中，STM32采集电压、电流、温度、SOC、继电器状态和充电开关状态，经ESP8266通过MQTT协议上传至OneNET平台；移动端APP通过物模型属性查询接口读取同一组数据，并在页面中显示系统运行状态。

本节通过OneNET云平台设备日志页面对消息订阅、属性上报和命令下行情况进行验证。设备日志页面能够显示设备端上报数据、平台接收消息以及控制命令下发记录，可用于判断设备端—云平台—移动端之间的数据链路是否正常。测试结果如图5-4所示。

图5.4 OneNET云平台设备日志页面

由图5.4可知，在网络信号良好的情况下，设备端消息订阅、属性上报和平台下行记录均能够正常显示，说明ESP8266、MQTT协议、OneNET平台和移动端APP之间的数据交互链路已经建立。为了进一步比较不同网络环境下的通信情况，对信号良好、信号一般和信号较弱三种情况进行了测试，结果如表5-2所示。

表5.2 MQTT 通信延迟测试结果

| 网络环境 | 平均延迟/s |  丢包情况  | 是否达标 |
|:---:|:---:|:---:|:---:|
| 信号良好 | \<1 | 无明显丢包 | 达标 |
| 信号一般 | \<1 | 无明显丢包 | 达标 |
| 信号较弱 | \<1 |  偶发重传  | 达标 |

由表5.2可知，在三种网络环境下，移动端平均显示延迟均小于任务书规定的1s。信号较弱时出现偶发重传，但设备端—OneNET—APP的数据链路仍保持连通。测试结果表明，本系统能够完成电压、电流、温度、SOC和继电器状态等数据的远程上传，并支持移动端状态查看和充电开关控制。

### 5.5 安全保护响应测试

安全保护响应测试用于验证本系统在过流、短路、过压和过温等异常情况下的动作情况。本设计将保护方式分为硬件保护和软件保护两类：硬件保护主要用于过流、短路等快速故障，通过关断功率通道降低故障持续时间；软件保护主要用于过压、过温、欠压和通信异常等状态判断，由 STM32 根据采样数据完成判断并执行关断或告警。

表5.3 保护响应时间测试结果

| 保护类型 | 故障条件 | 响应方式 | 响应时间 | 指标要求 | 是否达标 |
|---|---|---|---|---|---|
| 过流保护 | 电流超过阈值 | 硬件关断 | 6.8ms | ≤10ms | 达标 |
| 短路保护 | 输出近似短路 | 硬件关断 | 7.5ms | ≤10ms | 达标 |
| 过压保护 | 电池电压超限 | 软件关断 | 52ms | ≤100ms | 达标 |
| 过温保护 | 温度超过阈值 | 软件关断 | 76ms | ≤100ms | 达标 |

由表5.3可知，过流保护和短路保护响应时间分别为6.8ms和7.5ms，均小于10ms，满足硬件保护响应要求；过压保护和过温保护响应时间分别为52ms和76ms，均小于100ms，满足软件保护响应要求。保护触发后，系统通过关闭充电、断开继电器、OLED提示和MQTT告警等方式进入安全状态。测试结果表明，系统在设定故障条件下能够完成异常识别和保护动作。

### 5.6 系统续航测试

系统续航测试用于验证典型阴天光照条件下系统的连续运行能力。测试时接入3.7V、1200mAh锂电池，并保持OLED显示、采样模块、ESP8266通信和保护判断处于工作状态。由于太阳能电板额定功率为2W，阴天条件下实际输入功率低于额定值，因此测试中太阳能输入功率处于弱光条件下的合理范围内。

表5.4 阴天光照续航测试结果

| 测试时间/h | 电池电压/V | 太阳能输入功率/W | 系统状态 |
|:---:|:---:|:---:|:---:|
| 0 | 4.05 | 0.95 | 正常运行 |
| 2 | 3.96 | 0.88 | 正常运行 |
| 4 | 3.88 | 0.70 | 正常运行 |
| 6 | 3.81 | 0.60 | 正常运行 |

由表5.4可知，在典型阴天光照条件下，太阳能输入功率保持在0.60W—0.95W之间，低于太阳能板2W额定功率，符合弱光测试条件。系统连续运行6h后，电池电压由4.05V下降至3.81V，未触发欠压保护，OLED显示、参数采集、MQTT上传和保护判断均保持正常。测试结果表明，系统在当前测试条件下满足典型阴天光照下连续续航不低于6h的指标要求。

### 5.7 测试结果综合分析

综合各项测试结果可知，系统能够完成太阳能输入最大功率点跟踪、锂电池三阶段充电判断、远程数据上传、移动端显示控制和异常保护等功能。在MPPT测试中，系统能够根据太阳能输入端采样数据调整工作点，左右两侧工作点测试结果均满足94%以上的效率指标；在充电阶段切换测试中，电压误差和电流误差均控制在任务书要求范围内；在通信测试中，设备端—OneNET—APP链路能够稳定传输数据，通信延迟小于1s；在保护测试中，硬件保护和软件保护响应时间均满足设计要求；在续航测试中，系统能够在典型阴天光照条件下连续运行6h。

从系统不足来看，弱光条件下太阳能输入功率较小，采样波动对MPPT判断影响增大；Wi-Fi信号较弱时，MQTT通信会出现偶发重传；长时间运行时，DC-DC模块和功率通道存在一定温升，对系统效率和稳定性有一定影响。后续可从采样滤波、通信重连机制和功率模块散热等方面进一步优化。

### 5.8 本章小结

本章围绕MPPT效率、充电阶段切换精度、MQTT通信与移动端功能、安全保护响应和系统续航开展测试，并结合3.7V、1200mAh锂电池和2W太阳能电板参数对测试结果进行分析。测试结果表明，系统在当前实验条件下能够完成太阳能充电管理、关键参数采集、远程通信、移动端显示控制和异常保护等功能，各项测试结果基本满足任务书提出的性能指标，为本文结论提供了测试依据。

## 6 结论与展望

### 6.1 存在问题和解决方案

在本次基于STM32的锂电池太阳能智能充电系统设计与测试过程中，系统基本完成了太阳能输入管理、锂电池充电控制、参数采集、远程通信和异常保护等功能，但在样机实现和测试过程中仍存在一些不足。

首先，在弱光条件下，太阳能电板输出功率较小，输入端电压、电流容易受到环境变化和采样波动影响，导致MPPT程序在判断最大功率点附近工作状态时存在一定波动。针对这一问题，后续可在软件中进一步优化采样滤波方式，例如采用滑动平均滤波、限幅滤波或多次采样取平均的方法，降低瞬时采样误差对功率计算的影响。同时，也可结合变步长调节思路，在远离最大功率点时采用较大调节步长，在接近最大功率点时减小步长，从而兼顾跟踪速度和稳定性。

其次，系统通过ESP8266 Wi-Fi模块和MQTT协议接入OneNET平台，实现数据上报和移动端状态显示。但在Wi-Fi信号较弱或网络波动较大时，通信延迟会增加，数据刷新实时性受到一定影响。针对该问题，后续可在程序中增加MQTT断线重连机制和本地数据缓存机制，当网络短暂中断时先保存关键采样数据，待网络恢复后再继续上传，从而提高系统在复杂网络环境下的连续运行能力。

再次，系统采用模块化方式进行样机搭建，虽然便于调试和功能验证，但模块之间通过杜邦线和接口板连接，长时间运行时连接稳定性和抗干扰能力仍有提升空间。特别是DC-DC降压模块和功率通道在持续工作时会产生一定温升，可能影响系统效率和稳定性。后续可从功率器件选型、接口连接、线径选择和散热结构等方面进行优化，并进一步规范功率通道与弱信号采样通道的布局。

此外，移动端APP目前主要完成电压、电流、温度、SOC、充电开关和连接状态等信息显示，功能相对基础。后续可增加历史数据曲线、异常告警记录、设备运行日志和多状态统计等功能，使移动端不仅能够显示实时状态，也能够为系统长期运行分析提供数据参考。

### 6.2 总结

本文围绕“基于STM32的锂电池太阳能智能充电设计”课题，完成了系统方案设计、硬件模块选取、软件程序设计和系统测试分析。系统以STM32F103C8T6作为主控核心，结合太阳能输入、锂电池储能、DC-DC降压模块、电压电流采样模块、温度检测模块、继电器模块、OLED显示模块和ESP8266通信模块，实现了太阳能充电管理、关键参数采集、本地状态显示、安全保护和远程监测等功能。

在MPPT控制方面，本文首先分析了光伏电池输出特性和最大功率点变化规律，并对常用MPPT控制方法进行了比较，确定了适合本系统的控制思路。在系统实现中，STM32通过采集太阳能输入端电压、电流和功率变化，对工作点状态进行判断，并结合DC-DC降压模块完成输入端工作点调整，为提高太阳能输入利用率提供基础。

在锂电池充电管理方面，系统根据锂电池充电特性，完成涓流、恒流、恒压和满充判断等充电阶段控制。通过电压、电流、温度和SOC等参数采集，系统能够对电池状态进行判断，并通过继电器执行充电通断、电池通道切换和异常保护等动作，提高了充电过程的安全性和可控性。

在物联网通信方面，系统通过ESP8266 Wi-Fi模块接入OneNET平台，基于MQTT协议完成设备端数据上报和控制命令接收。移动端APP能够显示电压、电流、温度、SOC、电池通道和充电开关状态，并能够下发充电控制命令，实现了设备端、云平台和移动端之间的数据交互。

通过系统测试可知，在设定测试条件下，本系统MPPT效率达到94%以上，充电阶段切换精度满足电压±0.02V、电流±50mA的要求，Wi-Fi通信延迟小于1s，硬件保护和软件保护响应时间满足设计指标，系统在典型阴天光照条件下能够连续运行6h以上。测试结果表明，本文设计的系统能够完成任务书提出的主要功能要求，具有一定的工程实践价值。

### 6.3 展望

后续研究可从控制算法、硬件结构、通信稳定性和移动端功能等方面继续完善。在控制算法方面，可进一步优化MPPT控制策略，引入更稳定的滤波处理和变步长调节方法，提高弱光和光照突变条件下的跟踪稳定性。在硬件结构方面，可将现有模块化样机进一步优化为更加规范的PCB结构，减少接线误差和外部干扰，提高系统长期运行可靠性。

在通信功能方面，可完善MQTT断线重连、数据缓存和异常重传机制，使系统在网络环境不稳定时仍能够保持较好的数据连续性。在移动端功能方面，可增加历史曲线、告警记录、运行日志和设备状态统计等内容，使系统具备更完整的远程监测能力。随着后续功能的完善，该系统可进一步应用于小型太阳能充电装置、户外传感节点、便携式监测设备和低功耗物联网终端等场景。

## 参考文献

1.  <span id="_Ref3555" class="anchor"></span>金剑.太阳能光伏发电系统最大功率点跟踪技术及仿真\[J\].价值工程,2023,42(26):117-119.

2.  <span id="_Ref3832" class="anchor"></span>周玥,张岩,孟超.基于STM32的锂离子电池充电状态监测系统设计\[J\].中国现代教育装备,2024,(23):12-15.DOI:10.13492/j.cnki.cmee.2024.23.013.

3.  <span id="_Ref3907" class="anchor"></span>郭翠娟,暴宁,荣锋.基于MQTT的物联网平台研究与设计\[J\].计算机工程与设计,2022,43(08):2378-2384.DOI:10.16208/j.issn1000-7024.2022.08.036.

4.  <span id="_Ref4378" class="anchor"></span>胡小芳,余永纪,李玉蓉.太阳能光伏系统MPPT控制策略研究\[J\].科技与创新,2025,(17):37-39.DOI:10.15913/j.cnki.kjycx.2025.17.010.

5.  <span id="_Ref4100" class="anchor"></span>权保同.一种电导增量法的MPPT控制策略\[J\].中国科技信息,2025,(10):116-120.

6.  <span id="_Ref4567" class="anchor"></span>刘世勋,郑刘澎,连凯,等.基于STM32F0的双向DC-DC变换器设计\[J\].山西电子技术,2025,(04):6-8+16.

7.  <span id="_Ref3839" class="anchor"></span>Malele R H, Mendu B, Monchusi B B. Microcontroller-driven battery management in hybrid energy systems: a systematic review of applications, control strategies, and emerging trends\[J\]. IEEE Access, 2025.

8.  <span id="_Ref4456" class="anchor"></span>Xia B, Tang W, Yue X. Intelligent Outdoor Small Solar Charging System Based on STM32\[J\]. Theory and Practice of Science and Technology, 2024, 5(2): 20-31.

9.  <span id="_Ref4276" class="anchor"></span>Kok L C ,Fu X ,Koh Y Y , et al.A Novel Portable Solar Powered Wireless Charging Device\[J\].Electronics,2024,13(2):DOI:10.3390/ELECTRONICS13020403.

10. <span id="_Ref4110" class="anchor"></span>Andrasto T ,Primadiyono Y ,Hidayat S , et al.Incremental Conductance Method in Maximum Power Point Tracking\[J\].IOP Conference Series: Earth and Environmental Science,2024,1381(1):012023-012023.DOI:10.1088/1755-1315/1381/1/012023.

11. <span id="_Ref4459" class="anchor"></span>H H R ,P N S ,F A .Solar tracker design on solar panel for stm32 microcontroller based on battery charging system\[J\].IOP Conference Series: Earth and Environmental Science,2022,1115(1):DOI:10.1088/1755-1315/1115/1/012078.
