litang578-coder/Antigravity-Code/Antigravity-code/SYSTEM/usart/usart.c

#include "sys.h"

#include "usart.h"

//串口接收缓存区 	

u8 USART1_RX_BUF[USART1_MAX_RECV_LEN]; 				//接收缓冲,最大USART2_MAX_RECV_LEN个字节.

u8 USART1_TX_BUF[USART1_MAX_SEND_LEN]; 			  //发送缓冲,最大USART2_MAX_SEND_LEN字节

u16 USART1_RX_STA;   						//接收数据状态

/**************************************************************************

函数功能：串口1接收中断

入口参数：无

返回  值：无

**************************************************************************/

void USART1_IRQHandler(void)                	//串口1中断服务程序

{

	u8 res;

	if(USART_GetITStatus(USART1, USART_IT_RXNE) != RESET)  //接收中断(接收到的数据必须是0x0d 0x0a结尾)

	{

		res =USART1->DR;	//读取接收到的数据

		if(USART1_RX_STA<USART1_MAX_RECV_LEN)

		{

			USART1_RX_BUF[USART1_RX_STA++]=res;

		}

		else

		{

			USART1_RX_STA = 0;

		}

  }

}

//串口接收缓存区 	

u8 USART2_RX_BUF[USART2_MAX_RECV_LEN]; 				//接收缓冲,最大USART2_MAX_RECV_LEN个字节.

u8 USART2_TX_BUF[USART2_MAX_SEND_LEN]; 			  //发送缓冲,最大USART2_MAX_SEND_LEN字节

u16 USART2_RX_STA;   						//接收数据状态

/**************************************************************************

函数功能：串口2接收中断

入口参数：无

返回  值：无

**************************************************************************/

//void USART2_IRQHandler(void)

//{

//	u8 res;

//	if(USART_GetITStatus(USART2, USART_IT_RXNE) != RESET)//接收到数据

//	{	 

//		res =USART2->DR;

////		IM2181_DataReceive(res);

//		if(USART2_RX_STA<USART2_MAX_RECV_LEN) 

//		{

//			USART2_RX_BUF[0]=res;

//		}  	

//		else

//			USART2_RX_STA = 0;



//	}		

//}

//串口接收缓存区 	

u8 USART3_RX_BUF[USART3_MAX_RECV_LEN]; 				//接收缓冲,最大USART2_MAX_RECV_LEN个字节.

u8 USART3_TX_BUF[USART3_MAX_SEND_LEN]; 			  //发送缓冲,最大USART2_MAX_SEND_LEN字节

u16 USART3_RX_STA=0;   						//接收数据状态

/**************************************************************************

函数功能：串口3接收中断

入口参数：无

返回  值：无

**************************************************************************/

//void USART3_IRQHandler(void)

//{

//	u8 res;

//	if(USART_GetITStatus(USART3, USART_IT_RXNE) != RESET)//接收到数据

//	{	 

//		res =USART3->DR;

//		if(USART3_RX_STA<USART3_MAX_RECV_LEN) 

//		{

//			USART3_RX_BUF[0]=res;

//		}  	

//		else

//			USART3_RX_STA = 0;

//	}		

//}



void Usart_SendData(USART_TypeDef *USARTx, u8 data)

{

	USART_SendData(USARTx, data);

	while(USART_GetFlagStatus(USARTx, USART_FLAG_TC) == RESET);

}

void Usart_SendStr(USART_TypeDef *USARTx, unsigned char *str)

{

	while(*str!='\0')

	{

		USART_SendData(USARTx, *str++);									//发送数据

		while(USART_GetFlagStatus(USARTx, USART_FLAG_TC) == RESET);		//等待发送完成

	}

}

void Usart_SendStrLen(USART_TypeDef *USARTx, unsigned char *str, unsigned short len)

{

	unsigned short count = 0;

	for(; count < len; count++)

	{

		USART_SendData(USARTx, *str++);									//发送数据

		while(USART_GetFlagStatus(USARTx, USART_FLAG_TC) == RESET);		//等待发送完成

	}

}

//不可重入，不能与printf、sprintf同时调用

void UsartPrintf(USART_TypeDef *USARTx, char *fmt,...)   

{

	unsigned char UsartPrintfBuf[296];

	va_list ap;

	unsigned char *pStr = UsartPrintfBuf;

	

	va_start(ap, fmt);

	vsnprintf((char *)UsartPrintfBuf, sizeof(UsartPrintfBuf), fmt, ap);							//格式化

	va_end(ap);

	

	while(*pStr != 0)

	{

		USART_SendData(USARTx, *pStr++);

		while(USART_GetFlagStatus(USARTx, USART_FLAG_TC) == RESET);

	}

}

//printf重定向

int fputc(int ch, FILE *f)

{

	Usart_SendData(USART1,(unsigned char)ch);

	return (ch);

}

/**************************************************************************

函数功能：串口1初始化

入口参数： bound:波特率

返回  值：无

**************************************************************************/

void Usart1_Init(u32 bound){

  //GPIO端口设置

  GPIO_InitTypeDef GPIO_InitStructure;

	USART_InitTypeDef USART_InitStructure;

	NVIC_InitTypeDef NVIC_InitStructure;

	 

	RCC_APB2PeriphClockCmd(RCC_APB2Periph_USART1|RCC_APB2Periph_GPIOA, ENABLE);	//使能USART1，GPIOA时钟

  

	//USART1_TX   GPIOA.9

  GPIO_InitStructure.GPIO_Pin = GPIO_Pin_9; //PA.9

  GPIO_InitStructure.GPIO_Speed = GPIO_Speed_50MHz;

  GPIO_InitStructure.GPIO_Mode = GPIO_Mode_AF_PP;	//复用推挽输出

  GPIO_Init(GPIOA, &GPIO_InitStructure);//初始化GPIOA.9

   

  //USART1_RX	  GPIOA.10初始化

  GPIO_InitStructure.GPIO_Pin = GPIO_Pin_10;//PA10

  GPIO_InitStructure.GPIO_Mode = GPIO_Mode_IN_FLOATING;//浮空输入

  GPIO_Init(GPIOA, &GPIO_InitStructure);//初始化GPIOA.10  



  //Usart1 NVIC 配置

  NVIC_InitStructure.NVIC_IRQChannel = USART1_IRQn;

	NVIC_InitStructure.NVIC_IRQChannelPreemptionPriority=0 ;//抢占优先级3

	NVIC_InitStructure.NVIC_IRQChannelSubPriority = 0;		//子优先级3

	NVIC_InitStructure.NVIC_IRQChannelCmd = ENABLE;			//IRQ通道使能

	NVIC_Init(&NVIC_InitStructure);	//根据指定的参数初始化VIC寄存器

  

   //USART 初始化设置



	USART_InitStructure.USART_BaudRate = bound;//串口波特率

	USART_InitStructure.USART_WordLength = USART_WordLength_8b;//字长为8位数据格式

	USART_InitStructure.USART_StopBits = USART_StopBits_1;//一个停止位

	USART_InitStructure.USART_Parity = USART_Parity_No;//无奇偶校验位

	USART_InitStructure.USART_HardwareFlowControl = USART_HardwareFlowControl_None;//无硬件数据流控制

	USART_InitStructure.USART_Mode = USART_Mode_Rx | USART_Mode_Tx;	//收发模式

	

  USART_Init(USART1, &USART_InitStructure); //初始化串口1

  USART_ITConfig(USART1, USART_IT_RXNE, ENABLE);//开启串口接受中断

	USART_ClearFlag( USART1, USART_FLAG_TC );

  USART_Cmd(USART1, ENABLE);                    //使能串口1 



}

/**************************************************************************

函数功能：串口2初始化

入口参数： bound:波特率

返回  值：无

**************************************************************************/

void Usart2_Init(u32 bound)

{  



	NVIC_InitTypeDef NVIC_InitStructure;

	GPIO_InitTypeDef GPIO_InitStructure;

	USART_InitTypeDef USART_InitStructure;



	RCC_APB2PeriphClockCmd(RCC_APB2Periph_GPIOA, ENABLE);	// GPIOA时钟

	RCC_APB1PeriphClockCmd(RCC_APB1Periph_USART2,ENABLE); //串口2时钟使能



 	USART_DeInit(USART2);  //复位串口2

		 //USART2_TX   PA2

  GPIO_InitStructure.GPIO_Pin = GPIO_Pin_2; //PA2

  GPIO_InitStructure.GPIO_Speed = GPIO_Speed_50MHz;

  GPIO_InitStructure.GPIO_Mode = GPIO_Mode_AF_PP;	//复用推挽输出

  GPIO_Init(GPIOA, &GPIO_InitStructure); //初始化PA2

   

    //USART2_RX	  PA3

  GPIO_InitStructure.GPIO_Pin = GPIO_Pin_3;

  GPIO_InitStructure.GPIO_Mode = GPIO_Mode_IN_FLOATING;//浮空输入

  GPIO_Init(GPIOA, &GPIO_InitStructure);  //初始化PA3

	

	USART_InitStructure.USART_BaudRate = bound;//波特率设置

	USART_InitStructure.USART_WordLength = USART_WordLength_8b;//字长为8位数据格式

	USART_InitStructure.USART_StopBits = USART_StopBits_1;//一个停止位

	USART_InitStructure.USART_Parity = USART_Parity_No;//无奇偶校验位

	USART_InitStructure.USART_HardwareFlowControl = USART_HardwareFlowControl_None;//无硬件数据流控制

	USART_InitStructure.USART_Mode = USART_Mode_Rx | USART_Mode_Tx;	//收发模式

  	//设置中断优先级

	NVIC_InitStructure.NVIC_IRQChannel = USART2_IRQn;

	NVIC_InitStructure.NVIC_IRQChannelPreemptionPriority=0 ;//抢占优先级3

	NVIC_InitStructure.NVIC_IRQChannelSubPriority = 1;		//子优先级3

	NVIC_InitStructure.NVIC_IRQChannelCmd = ENABLE;			//IRQ通道使能

	NVIC_Init(&NVIC_InitStructure);	//根据指定的参数初始化VIC寄存器

	//使能接收中断

  USART_ITConfig(USART2, USART_IT_RXNE, ENABLE);

  USART_ITConfig(USART2, USART_IT_IDLE, ENABLE);  // IDLE中断用于快速帧检测//开启中断   

	USART_Init(USART2, &USART_InitStructure);     //初始化串口2

  USART_ClearFlag( USART2, USART_FLAG_TC );

	USART_Cmd(USART2, ENABLE);                    //使能串口 

}









/**************************************************************************

函数功能：串口3初始化

入口参数： bound:波特率

返回  值：无

**************************************************************************/

void Usart3_Init(u32 bound)

{  	 

	  //GPIO端口设置

  GPIO_InitTypeDef GPIO_InitStructure;

	USART_InitTypeDef USART_InitStructure;

	NVIC_InitTypeDef NVIC_InitStructure;

	 

	RCC_APB2PeriphClockCmd(RCC_APB2Periph_GPIOB, ENABLE);	//使能UGPIOB时钟

  RCC_APB1PeriphClockCmd(RCC_APB1Periph_USART3, ENABLE);	//使能USART3时钟

	//USART3_TX  

  GPIO_InitStructure.GPIO_Pin = GPIO_Pin_10; //PB.10

  GPIO_InitStructure.GPIO_Speed = GPIO_Speed_50MHz;

  GPIO_InitStructure.GPIO_Mode = GPIO_Mode_AF_PP;	//复用推挽输出

  GPIO_Init(GPIOB, &GPIO_InitStructure);

   

  //USART3_RX	  

  GPIO_InitStructure.GPIO_Pin = GPIO_Pin_11;//PB11

  GPIO_InitStructure.GPIO_Mode = GPIO_Mode_IN_FLOATING;//浮空输入

  GPIO_Init(GPIOB, &GPIO_InitStructure);



  //Usart3 NVIC 配置

  NVIC_InitStructure.NVIC_IRQChannel = USART3_IRQn;

	NVIC_InitStructure.NVIC_IRQChannelPreemptionPriority=0 ;//抢占优先级

	NVIC_InitStructure.NVIC_IRQChannelSubPriority = 2;		//子优先级

	NVIC_InitStructure.NVIC_IRQChannelCmd = ENABLE;			//IRQ通道使能

	NVIC_Init(&NVIC_InitStructure);	//根据指定的参数初始化VIC寄存器

   //USART 初始化设置

	USART_InitStructure.USART_BaudRate = bound;//串口波特率

	USART_InitStructure.USART_WordLength = USART_WordLength_8b;//字长为8位数据格式

	USART_InitStructure.USART_StopBits = USART_StopBits_1;//一个停止位

	USART_InitStructure.USART_Parity = USART_Parity_No;//无奇偶校验位

	USART_InitStructure.USART_HardwareFlowControl = USART_HardwareFlowControl_None;//无硬件数据流控制

	USART_InitStructure.USART_Mode = USART_Mode_Rx | USART_Mode_Tx;	//收发模式

  USART_Init(USART3, &USART_InitStructure);     //初始化串口3

  USART_ITConfig(USART3, USART_IT_RXNE, ENABLE);//开启串口接受中断

	USART_ClearFlag( USART3, USART_FLAG_TC );

  USART_Cmd(USART3, ENABLE);                    //使能串口3 

}
