litang578-coder/Antigravity-Code/Antigravity-code/HARDWAR/OLED.h

#ifndef __OLED_H_
#define __OLED_H_

/****************************
 * OLED IIC 端口定义
 ****************************/
#define GPIO_SCL GPIOB
#define GPIO_SDA GPIOB

#define GPIO_Pin_SCL GPIO_Pin_6
#define GPIO_Pin_SDA GPIO_Pin_7

#define OLED_RCC_SCL RCC_APB2Periph_GPIOB
#define OLED_RCC_SDA RCC_APB2Periph_GPIOB

/* 字库头文件: F6x8[][8]  F8X16[][16]  BMP1[]  Hzk[][32] */
#include "stdlib.h"
#include "delay.h"
#include <stdarg.h>
#include <string.h>
#include <stdio.h>

#define OLED_MODE 0
#define SIZE 8
#define XLevelL		0x00
#define XLevelH		0x10
#define Max_Column	128
#define Max_Row		64
#define	Brightness	0xFF
#define X_WIDTH 	128
#define Y_WIDTH 	64

#define OLED_SCLK_Clr() GPIO_ResetBits(GPIO_SCL,GPIO_Pin_SCL) /* SCL 拉低 */
#define OLED_SCLK_Set() GPIO_SetBits(GPIO_SCL,GPIO_Pin_SCL)   /* SCL 拉高 */

#define OLED_SDIN_Clr() GPIO_ResetBits(GPIO_SDA,GPIO_Pin_SDA) /* SDA 拉低 */
#define OLED_SDIN_Set() GPIO_SetBits(GPIO_SDA,GPIO_Pin_SDA)   /* SDA 拉高 */

#define OLED_CMD  0	/* 写命令 */
#define OLED_DATA 1	/* 写数据 */

/* 显示函数 */
void OLED_printf(u8 x,u8 y,char *fmt,...);          /* 格式化打印字符串 */
void OLED_ShowStr(u8 x,u8 y, u8 *p,u8 Char_Size);  /* 显示字符串 */
void OLED_ShowCH(u8 x,u8 y,u8 no);                  /* 显示汉字 */
void OLED_ShowBMP(unsigned char x0, unsigned char y0,unsigned char x1, unsigned char y1,unsigned char BMP[]);
void OLED_ShowNum(u8 x,u8 y,int num,u8 len,u8 size);/* 显示数字 */

/* OLED 控制函数 */
void OLED_WR_Byte(unsigned dat,unsigned cmd);
void OLED_Display_On(void);
void OLED_Display_Off(void);
void OLED_Init(void);
void OLED_Clear(void);
void OLED_ShowChar(u8 x,u8 y,u8 chr,u8 Char_Size);
void OLED_Set_Pos(unsigned char x, unsigned char y);

/* 延时函数 */
void Delay_50ms(unsigned int Del_50ms);
void Delay_1ms(unsigned int Del_1ms);

/* IIC 底层函数 */
void fill_picture(unsigned char fill_Data);
void OLED_IIC_Start(void);
void OLED_IIC_Stop(void);
void Write_IIC_Command(unsigned char IIC_Command);
void Write_IIC_Data(unsigned char IIC_Data);
void Write_IIC_Byte(unsigned char IIC_Byte);
void IIC_Wait_Ack(void);

#endif
