litang578-coder/Antigravity-Code/(commit log)

2026-05-04 首次提交
2026-05-10 Refactor hardware configurations, optimize MPPT control and OneNet communication
    - Remove unused hardware drivers (DHT11, DS1302, GPS, MLX90614, etc.)
    - Relocate relay GPIO pin to PA12 and update initialization
    - Stabilize INA3221 measurements for PV monitoring
    - Optimize OneNet transmission with USART idle interrupts
    [IO_Init.c, IO_Init.h, ina3221.c, ina3221.h, main.c]
2026-05-17 优化云端数据通信机制及前端状态控制逻辑
    - 设备端：属性上报 QoS 降级为 0，新增订阅 post/reply 主题，修复解析函数缺失的 break；
    - 移动端：优化数据轮询与接口超时机制，重构充电状态下发确认逻辑以增强按钮反馈与状态同步的可靠性。
2026-05-20 修正MPPT补偿参考值计算
2026-05-20 Revert "修正MPPT补偿参考值计算"
    This reverts commit 7f4154a8ab6ed8b08023097836bc86dfd7d8c4c0.
    [Test_MPPT.c, Test_MPPT.h, mppt.h]
2026-05-20 同步硬件采样与前端显示调整
2026-05-20 恢复Test_MPPT头文件
2026-05-20 修复MPPT效率字段缺失
2026-05-21 完善太阳能充电控制与MPPT参考计算
2026-05-21 添加脱敏毕业论文README
2026-05-21 删除毕业论文README
2026-05-23 完善MPPT曲线与OneNET功率上报
2026-05-23 完善MPPT数据显示与远程控制响应
2026-05-25 feat: 优化MPPT仿真算法并为前端APP引入调试面板
    - MPPT仿真优化 (Test_MPPT.c)：新增 Test_MPPT_FastRipple 快速纹波模拟函数，优化各电压窗口下的查找表，引入动态纹波扰动以提高真实性。
    - 前端APP优化 (APP_2/index.vue等)：新增设备数据请求调试信息面板，支持网络请求状态及错误的直观展示与记录。
2026-05-25 chore: 添加 .gitignore 并移除已追踪的 uni-app 编译产物与缓存
    - 在根目录下添加 .gitignore 配置文件，自动忽略 HBuilderX 的本地配置、缓存和编译产生的 APK 包。
    - 使用 git rm -r --cached 移除对已存在在 Git 中的 unpackage 文件夹的追踪，使其正式遵循忽略规则。
2026-06-01 完善MPPT控制与OneNET重连逻辑
2026-06-08 更新硬件驱动、网络通信及系统模块：优化OLED显示、编码器、INA226电流传感器、Modbus通信、PWM控制、定时器、MQTT协议、OneNET平台接入、串口及系统延时等功能
